suspaceflight/lora-tracker/slim-board/slim-lora.png

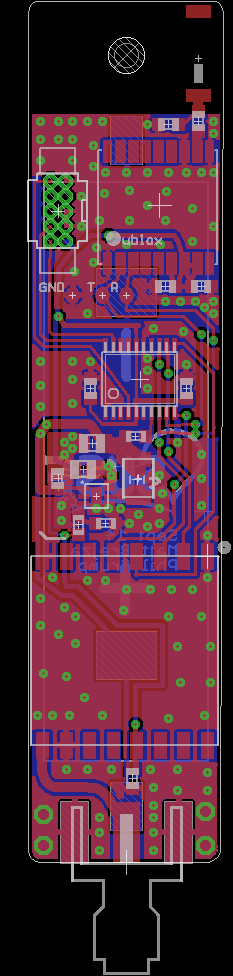
slim-board/slim-lora.png
