suspaceflight/lora-tracker/basestation-board/switchcap.SLDPRT

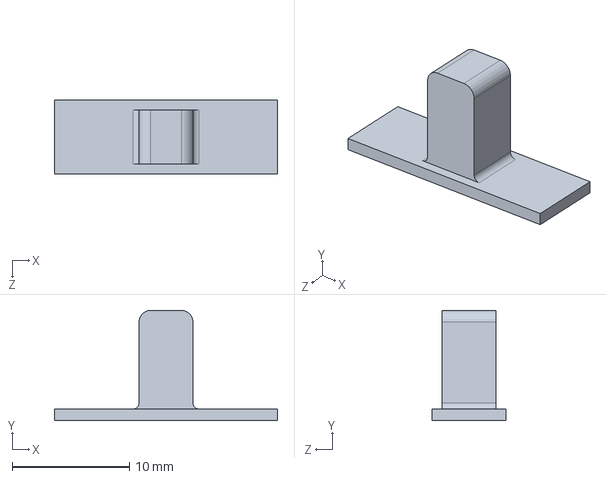
[picture p2: CAD file, 2015-01-24]
basestation-board/switchcap.SLDPRT
19.0 x 9.40 x 6.30 mm
