suspaceflight/lora-tracker/basestation-board/basestation.brd

## EAGLE design basestation-board/basestation.brd (2014-10-27)

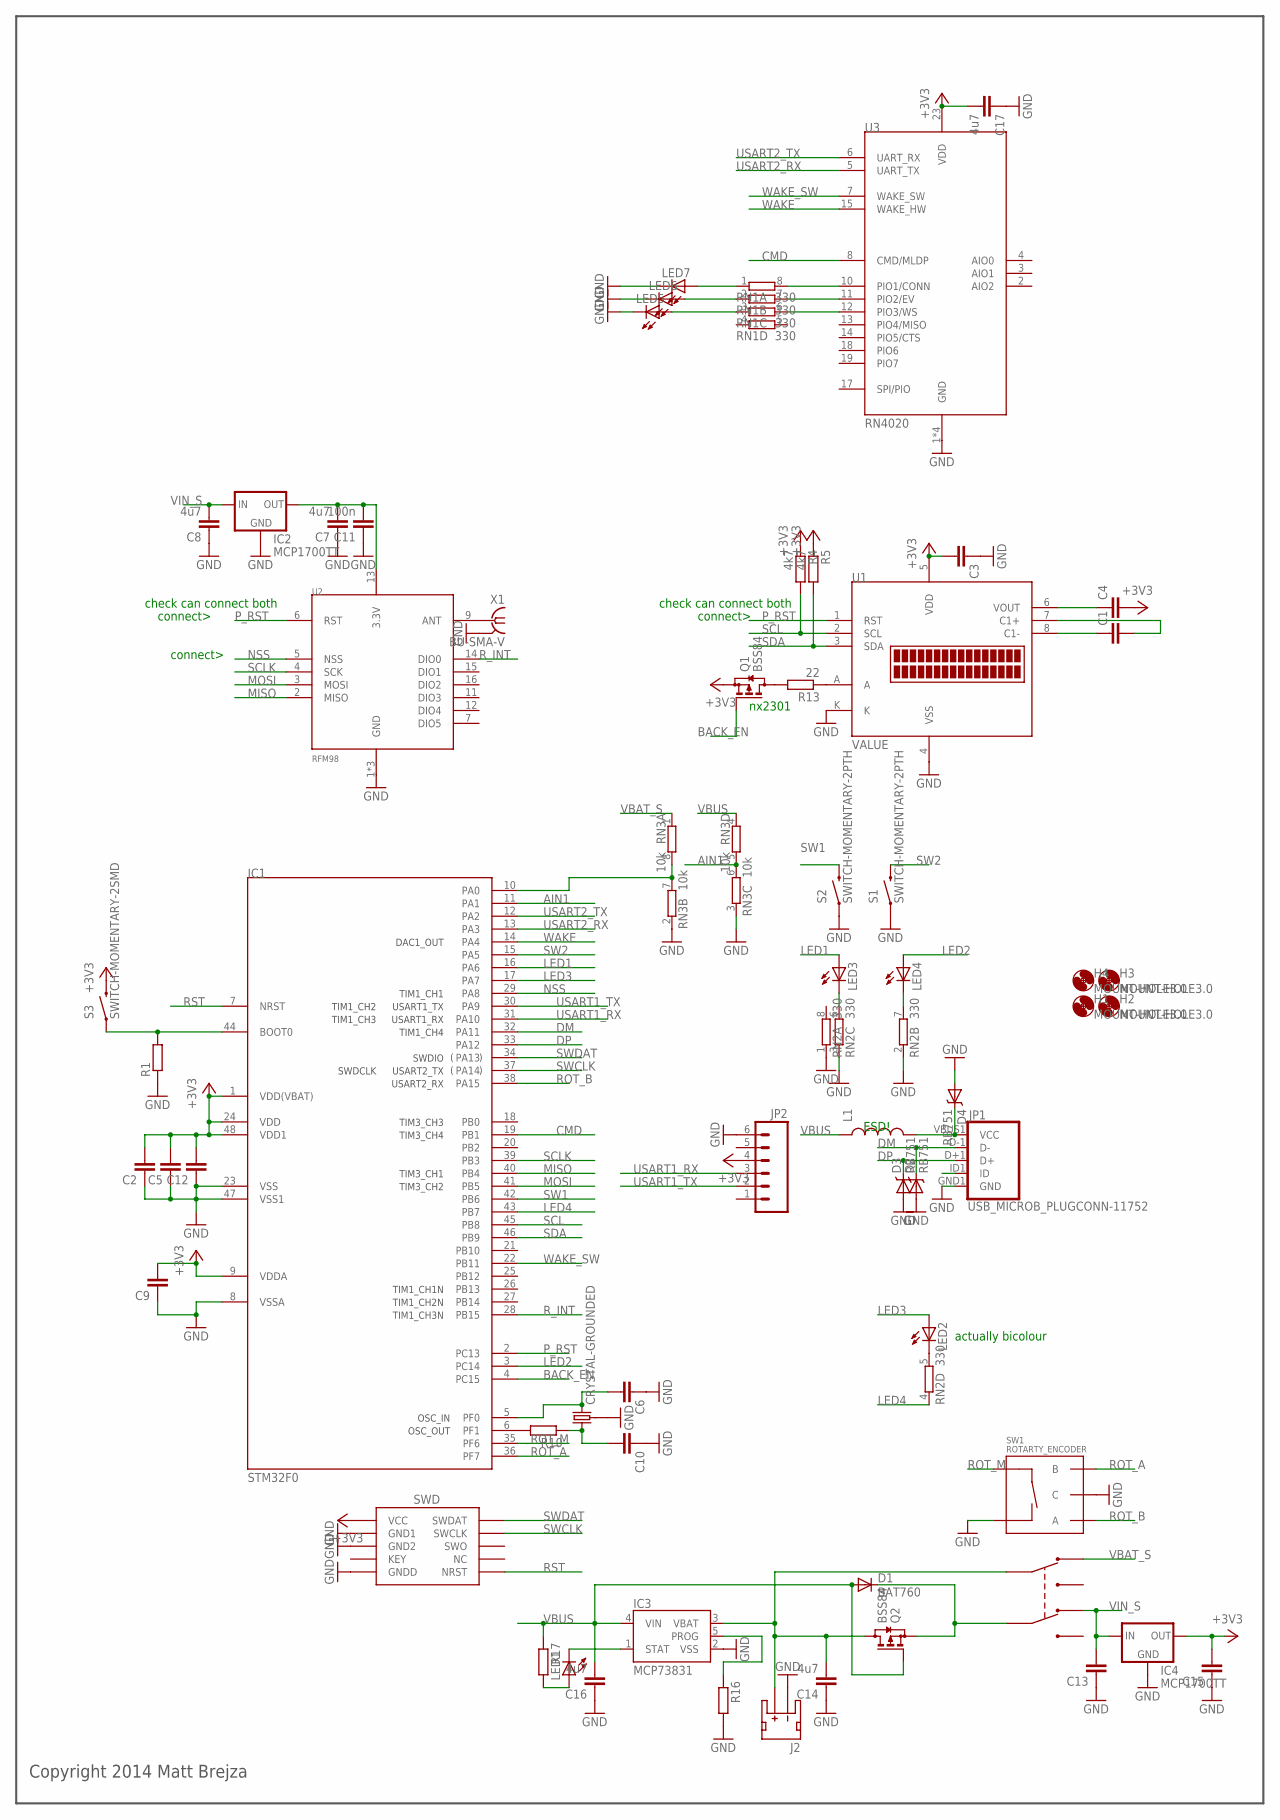
[picture p3: schematic basestation.sch]

Parts:
C1, C2, C3, C4, C5, C6, C9, C10, C12, C13, C15: C-EUC0603; C0603
C7, C8, C14, C16, C17: 4u7; C0603
C11: 100n; C0603
D1: BAT760; SOD323-R
D2, D3, D4: RB751; SOD-523
H1, H2, H3, H4: MOUNT-HOLE3.0; 3,0
IC1: STM32F0; TQFP48
IC2, IC4: MCP1700TT; SOT23
IC3: MCP73831; SOT23-5
J1: SWD_SHROUD_SMD; SWD_SMD_SHROUD
J2: JST_2MM_MALE; JST-2-SMD
JP1: USB_MICROB_PLUGCONN-11752; USB-B-MICRO-SMD_V03
JP2: M06SMD; 1X06-SMD
L1: INDUCTOR0603; 0603
LED1, LED5, LED6, LED7: LEDCHIP-LED0805; CHIP-LED0805
LED2: LED5MM
LED3, LED4: LED3MM
Q1, Q2: BSS84; SOT23
R1, R10, R16, R17: R-EU_R0603; R0603
R4, R5: 4k7; R0603
R13: 22; R0603
RN1, RN2: 330; EXB38V
RN3: 10k; EXB38V
S1, S2: SWITCH-MOMENTARY-2PTH; TACTILE-PTH
S3: SWITCH-MOMENTARY-2SMD; TACTILE_SWITCH_SMD
SW1: ROTARTY_ENCODER; ROTARY_ENC_PLAIN
U1: NHD-C0216CIZ-FSW
U2: RFM98; RFM97
U3: RN4020
U$1: DPDTSLIDE
X1: BU-SMA-V
X2: CRYSTAL-GROUNDED; CRYSTAL-SMD-5X3

Connections:
3.3V: C7.2, C11.2, IC2.2 (OUT), U2.13 (3.3V)
+3V3: C2.2, C3.2, C4.2, C5.2, C9.2, C12.2, C15.2, C17.2, IC1.1 (VDD(VBAT)), IC1.9 (VDDA), IC1.24 (VDD), IC1.48 (VDD1), IC4.2 (OUT), J1.1 (VCC), JP2.4, Q1.2 (S), R4.1, R5.1, S3.3 (2), U1.5 (VDD), U3.23 (VDD)
AIN1: IC1.11 (PA1), RN3.5 (2), RN3.6 (2)
BACK_EN: IC1.4 (PC15), Q1.1 (G)
CMD: IC1.19 (PB1), U3.8 (CMD/MLDP)
DM: D2.C, IC1.32 (PA11), JP1.D-1 (D-)
DP: D3.C, IC1.33 (PA12), JP1.D+1 (D+)
GND: C2.1, C3.1, C5.1, C6.1, C7.1, C8.1, C9.1, C10.1, C11.1, C12.1, C13.1, C14.1, C15.1, C16.1, C17.1, D2.A, D3.A, D4.A, IC1.8 (VSSA), IC1.23 (VSS), IC1.47 (VSS1), IC2.1 (GND), IC3.2 (VSS), IC4.1 (GND), J1.3 (GND1), J1.5 (GND2), J1.9 (GNDD), J2.1 (-), JP1.GND1 (GND), JP2.6, LED5.C, LED6.C, LED7.C, R1.1, R16.2, RN2.1, RN2.2 (1), RN2.3 (1), RN3.2 (1), RN3.3 (1), S1.1, S2.1, SW1.C, SW1.SW-, U1.4 (VSS), U1.K, U2.1 (GND), U2.8 (GND), U2.10 (GND), U3.1 (GND), U3.9 (GND), U3.16 (GND), U3.24 (GND), X1.2, X1.3 (2), X1.4 (2), X1.5 (2), X2.2 (3), X2.4 (3)
LED1: IC1.16 (PA6), LED3.A
LED2: IC1.3 (PC14), LED4.A
LED3: IC1.17 (PA7), LED2.A
LED4: IC1.43 (PB7), RN2.4 (1)
MISO: IC1.40 (PB4), U2.2 (MISO)
MOSI: IC1.41 (PB5), U2.3 (MOSI)
unnamed: U2.9 (ANT), X1.1
unnamed: D1.C, Q2.2 (S), U$1.2X (COM1)
unnamed: Q1.3 (D), R13.2
unnamed: IC1.44 (BOOT0), R1.2, S3.1
unnamed: RN1.8 (2), U3.10 (PIO1/CONN)
unnamed: LED3.K (C), RN2.6 (2)
unnamed: IC3.5 (PROG), R16.1
unnamed: C1.1, U1.8 (C1-)
unnamed: C1.2, U1.7 (C1+)
unnamed: LED4.K (C), RN2.7 (2)
unnamed: LED2.K (C), RN2.5 (2)
unnamed: C4.1, U1.6 (VOUT)
unnamed: RN1.7 (2), U3.11 (PIO2/EV)
unnamed: RN1.6 (2), U3.12 (PIO3/WS)
unnamed: LED7.A, RN1.1
unnamed: LED6.A, RN1.2 (1)
unnamed: LED5.A, RN1.3 (1)
unnamed: R13.1, U1.A
unnamed: IC1.10 (PA0), RN3.7 (2), RN3.8 (2)
unnamed: IC3.1 (STAT), LED1.C
unnamed: IC1.6 (PF1), R10.2
unnamed: C6.2, IC1.5 (PF0), X2.1 (2)
unnamed: C10.2, R10.1, X2.3 (1)
unnamed: C14.2, IC3.3 (VBAT), J2.2 (+), Q2.3 (D), U$1.1X (COM0)
unnamed: LED1.A, R17.2
unnamed: D4.C, JP1.VBUS1 (VCC), L1.2
NSS: IC1.29 (PA8), U2.5 (NSS)
P_RST: IC1.2 (PC13), U1.1 (RST), U2.6 (RST)
ROT_A: IC1.36 (PF7), SW1.B
ROT_B: IC1.38 (PA15), SW1.A
ROT_M: IC1.35 (PF6), SW1.SW+
RST: IC1.7 (NRST), J1.10 (NRST)
R_INT: IC1.28 (PB15), U2.14 (DIO0)
SCL: IC1.45 (PB8), R4.2, U1.2 (SCL)
SCLK: IC1.39 (PB3), U2.4 (SCK)
SDA: IC1.46 (PB9), R5.2, U1.3 (SDA)
SW1: IC1.42 (PB6), S2.3 (2)
SW2: IC1.15 (PA5), S1.3 (2)
SWCLK: IC1.37 (PA14), J1.4 (SWCLK)
SWDAT: IC1.34 (PA13), J1.2 (SWDAT)
USART1_RX: IC1.31 (PA10), JP2.3
USART1_TX: IC1.30 (PA9), JP2.2
USART2_RX: IC1.13 (PA3), U3.5 (UART_TX)
USART2_TX: IC1.12 (PA2), U3.6 (UART_RX)
VBAT_S: RN3.1, U$1.1A (NC0)
VBUS: C16.2, D1.A, IC3.4 (VIN), L1.1, Q2.1 (G), R17.1, RN3.4 (1)
VIN_S: C8.2, C13.2, IC2.3 (IN), IC4.3 (IN), U$1.2A (NC1)
WAKE: IC1.14 (PA4), U3.15 (WAKE_HW)
WAKE_SW: IC1.22 (PB11), U3.7 (WAKE_SW)

Notes on the sheet:
actually bicolour
connect>
nx2301
ESD!
check can connect both
Copyright 2014 Matt Brejza

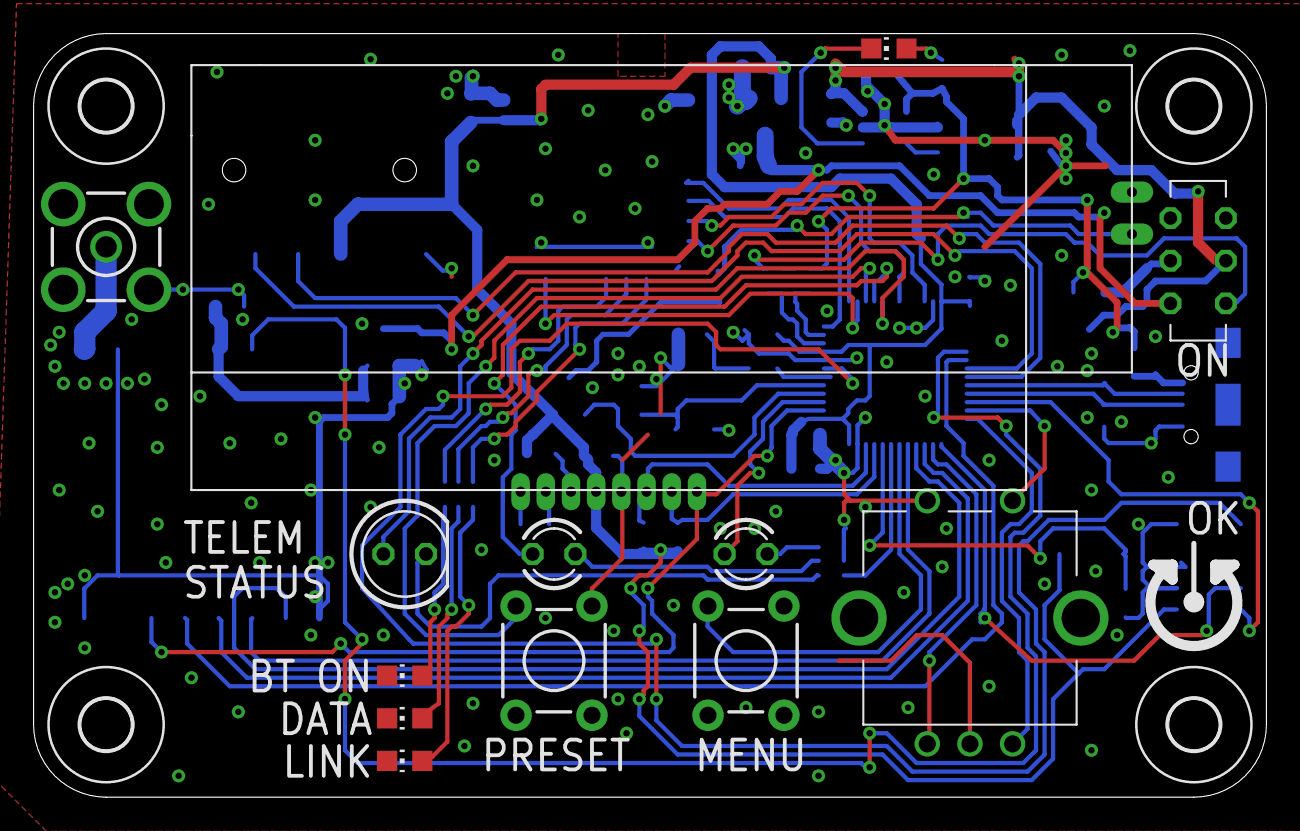
[picture p4: board basestation.brd from above]

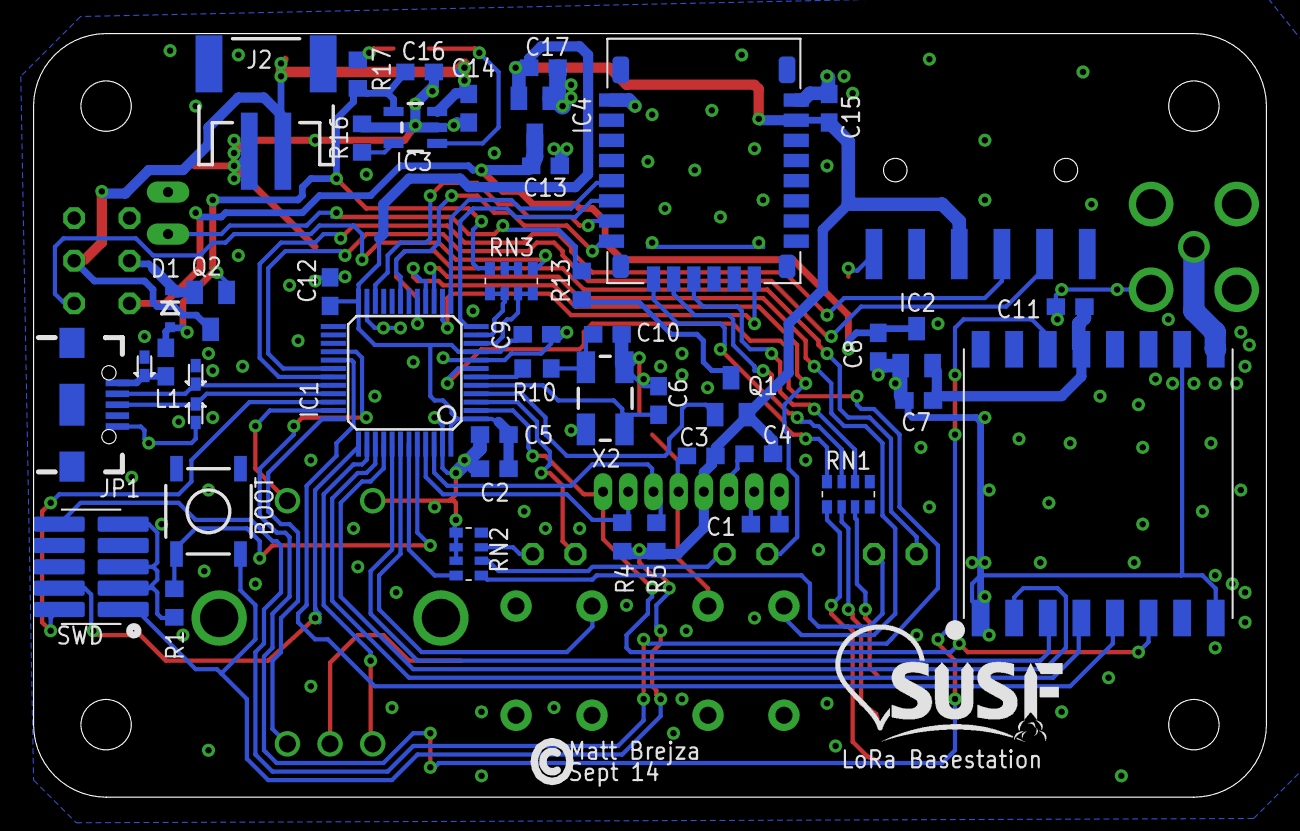
[picture p5: board basestation.brd from below]

Board: 2 copper layers, 73.4 x 45.5 mm, 64 parts (47 on the bottom side), 63 nets.

Other parts of the board:
U$2: SUSF-XSM
