suspaceflight/lora-tracker/th-lora/th-lora.brd

## EAGLE design th-lora/th-lora.brd (2014-10-27)

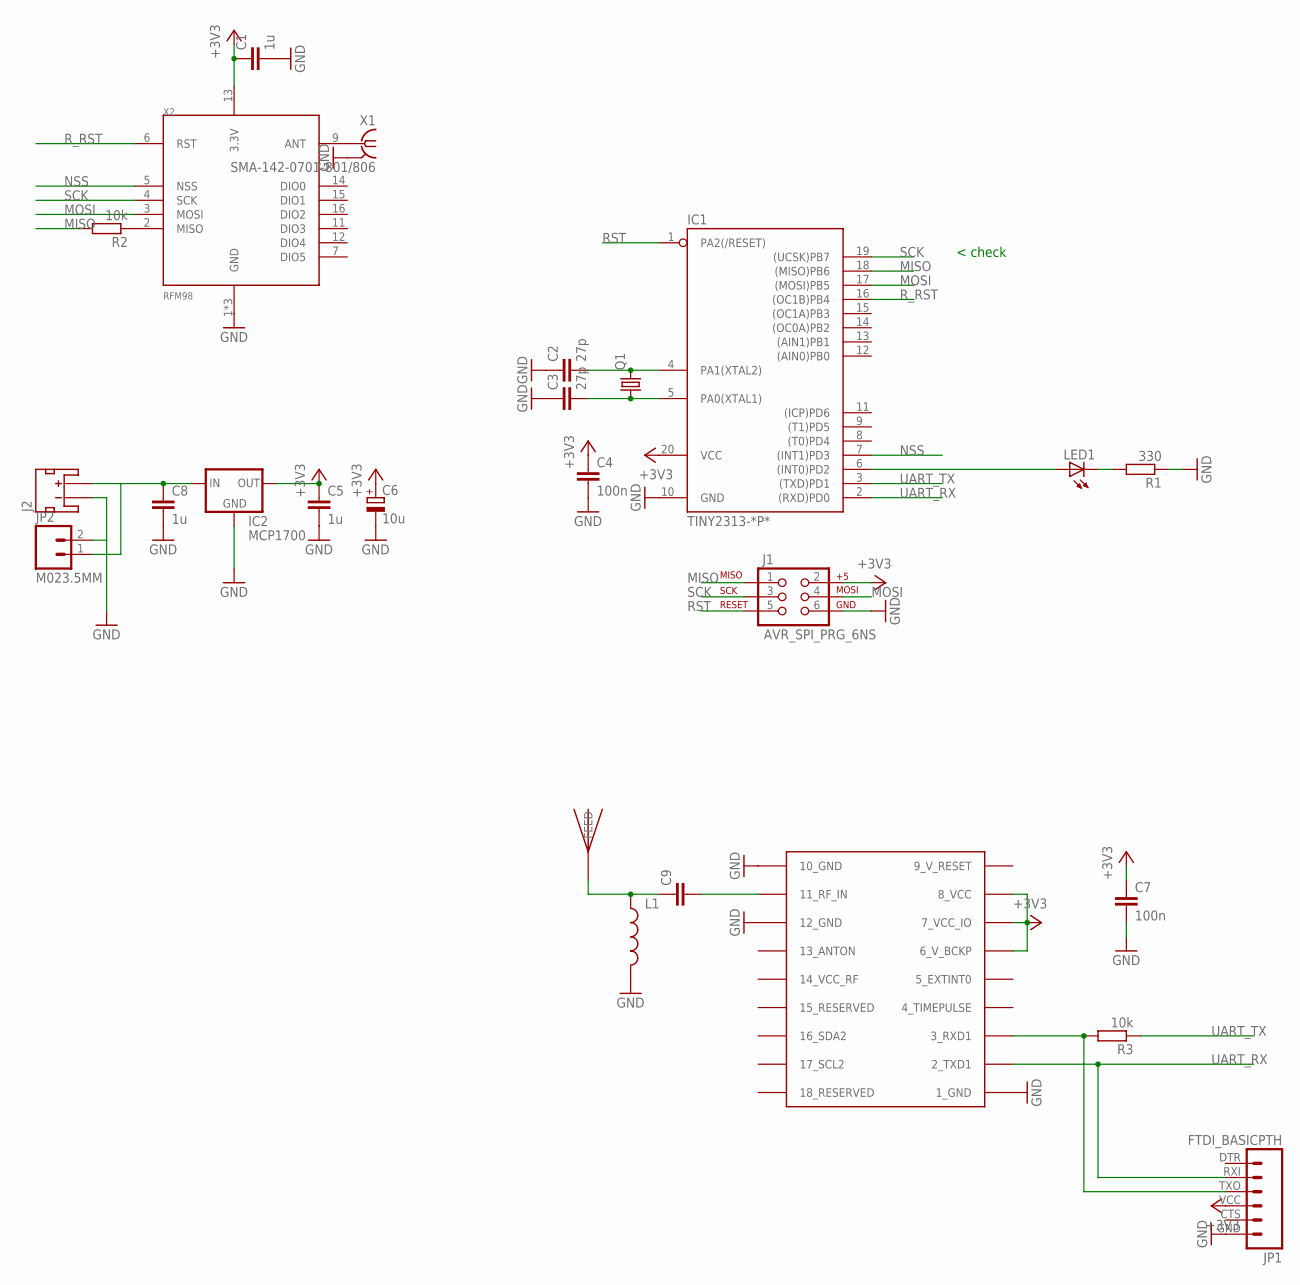
[picture p6: schematic th-lora.sch]

Parts:
C1, C5, C8: 1u; C050-025X075
C2, C3: 27p; C050-025X075
C4, C7: 100n; C050-025X075
C6: 10u; E2,5-5
C9: C-EUC0603; C0603
IC1: TINY2313-*P*; DIL20
IC2: MCP1700; TO92-INLINE
J1: AVR_SPI_PRG_6NS; 2X3-NS
J2: JST_2MM_MALE; JST-2-SMD
JP1: FTDI_BASICPTH; FTDI_BASIC
JP2: M023.5MM; SCREWTERMINAL-3.5MM-2
L1: INDUCTOR0603; 0603
LED1: LED3MM
Q1: CRYSTALHC49S; HC49/S
R1: 330; 0204/7
R2, R3: 10k; 0204/7
U$3: JTI_ANTENNA-1575AT43A40
X1: SMA-142-0701-801/806; J502-ND-142-0701-801/806
X2: RFM98; RFM97
X3: UBLOX_MAX

Connections:
9_V_RESET: X3.9_V_RESET
+3V3: C1.1, C4.1, C5.1, C6.+, C7.1, IC1.20 (VCC), IC2.VOUT (OUT), J1.2, JP1.VCC (4), X2.13 (3.3V), X3.6_V_BCKP, X3.7_VCC_IO, X3.8_VCC
GND: C1.2, C2.1, C3.1, C4.2, C5.2, C6.-, C7.2, C8.2, IC1.10 (GND), IC2.GND, J1.6, J2.1 (-), JP1.GND (6), JP2.2, L1.2, R1.1, X1.G@1 (2), X1.G@2 (2), X1.G@3 (2), X1.G@4 (2), X2.1 (GND), X2.8 (GND), X2.10 (GND), X3.1_GND, X3.10_GND, X3.12_GND
MISO: IC1.18 ((MISO)PB6), J1.1, R2.2
MOSI: IC1.17 ((MOSI)PB5), J1.4, X2.3 (MOSI)
unnamed: C9.2, X3.11_RF_IN
unnamed: X1.1, X2.9 (ANT)
unnamed: LED1.K (C), R1.2
unnamed: C9.1, L1.1, U$3.FEED
unnamed: C2.2, IC1.4 (PA1(XTAL2)), Q1.2
unnamed: C3.2, IC1.5 (PA0(XTAL1)), Q1.1
unnamed: C8.1, IC2.VIN (IN), J2.2 (+), JP2.1
unnamed: IC1.6 ((INT0)PD2), LED1.A
unnamed: JP1.TXO (3), R3.2, X3.3_RXD1
unnamed: R2.1, X2.2 (MISO)
NSS: IC1.7 ((INT1)PD3), X2.5 (NSS)
RST: IC1.1 (PA2(/RESET)), J1.5
R_RST: IC1.16 ((OC1B)PB4), X2.6 (RST)
SCK: IC1.19 ((UCSK)PB7), J1.3, X2.4 (SCK)
UART_RX: IC1.2 ((RXD)PD0), JP1.RXI (2), X3.2_TXD1
UART_TX: IC1.3 ((TXD)PD1), R3.1

Notes on the sheet:
< check

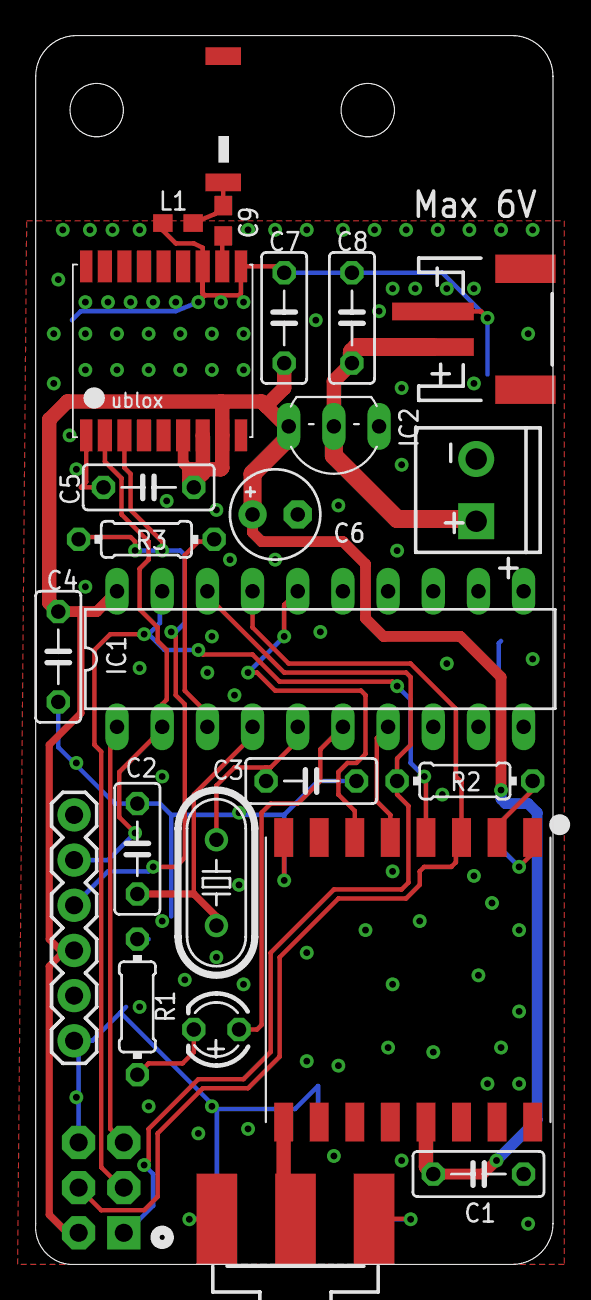
[picture p7: board th-lora.brd from above]

Board: 2 copper layers, 29.1 x 69.1 mm, 26 parts (1 on the bottom side), 20 nets.

Other parts of the board:
U$4: SUSF-XSM
