suspaceflight/lora-tracker/slim-board/lora-slim.brd

## EAGLE design slim-board/lora-slim.brd (2014-10-27)

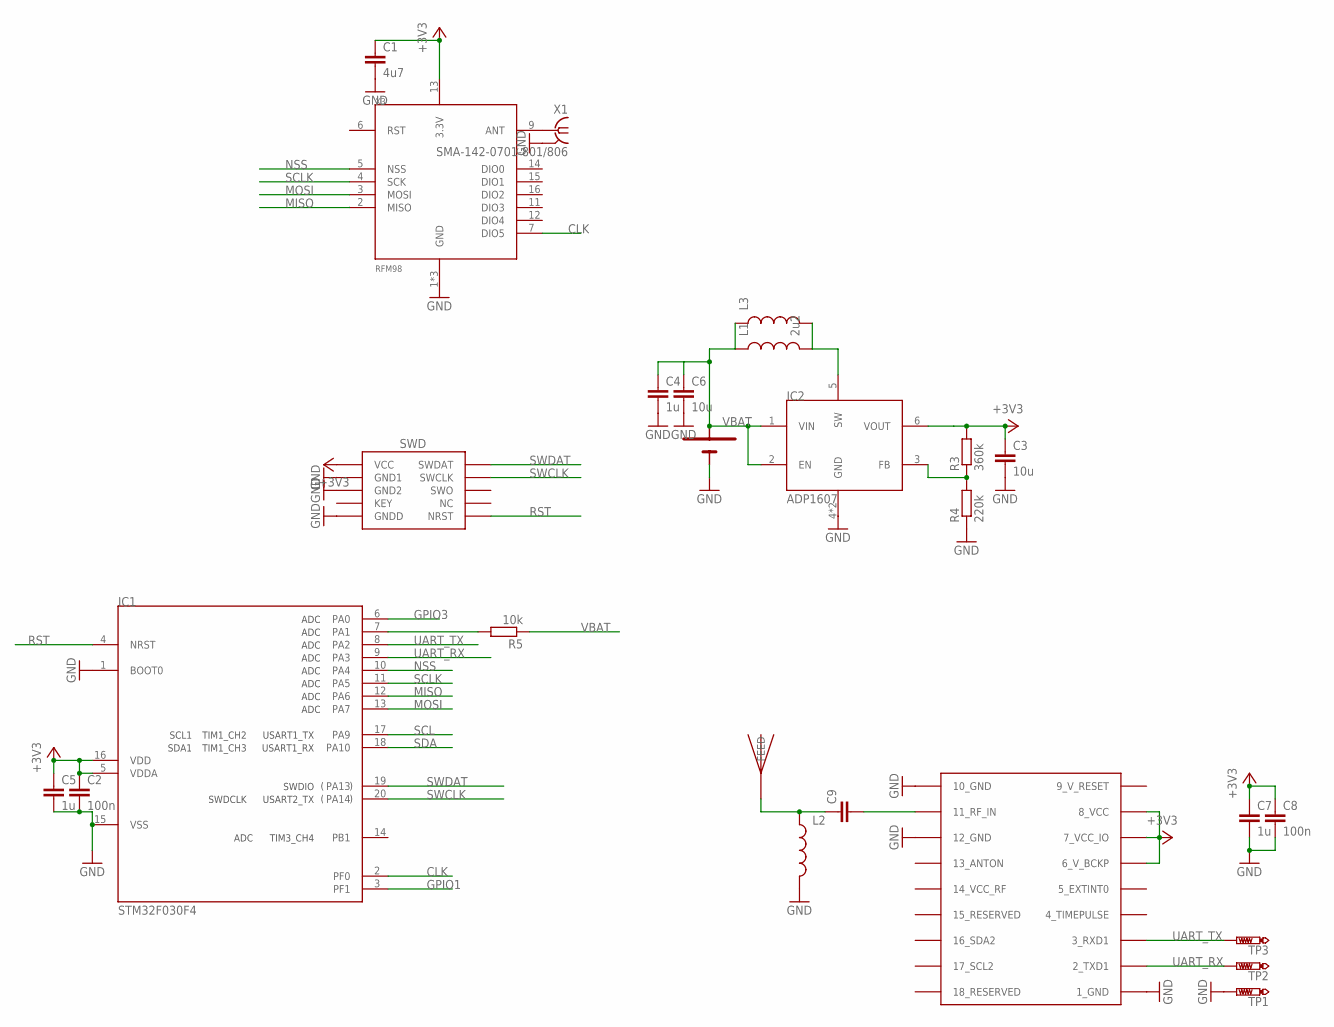
[picture p8: schematic lora-slim.sch]

Parts:
C1: 4u7; C0603
C2, C8: 100n; C0603
C3, C6: 10u; C0805
C4, C5, C7: 1u; C0603
C9: C-EUC0603; C0603
IC1: STM32F030F4; TSSOP20
IC2: ADP1607; LFCSP6
J1: SWD_PTH_SHROUD
L1: 2u2; 0805
L2: INDUCTOR0603; 0603
L3: INDUCTOR1210; 1210
R3: 360k; R0603
R4: 220k; R0603
R5: 10k; R0603
TP1, TP2, TP3: PTR1B1,27; B1,27
U$5: JTI_ANTENNA-1575AT43A40
U$6: KEYSTONE-53; KEYSTONE53
X1: SMA-142-0701-801/806; J502-ND-142-0701-801/806
X2: UBLOX_MAX
X3: RFM98; RFM97

Connections:
9_V_RESET: X2.9_V_RESET
+3V3: C1.1, C2.1, C3.1, C5.1, C7.1, C8.1, IC1.5 (VDDA), IC1.16 (VDD), IC2.6 (VOUT), J1.1 (VCC), R3.2, X2.6_V_BCKP, X2.7_VCC_IO, X2.8_VCC, X3.13 (3.3V)
CLK: IC1.2 (PF0), X3.7 (DIO5)
GND: C1.2, C2.2, C3.2, C4.2, C5.2, C6.2, C7.2, C8.2, IC1.1 (BOOT0), IC1.15 (VSS), IC2.4 (GND), IC2.EP (GND), J1.3 (GND1), J1.5 (GND2), J1.9 (GNDD), L2.2, R4.1, TP1.TP, U$6.N1 (-), U$6.N2 (-), X1.G@1 (2), X1.G@2 (2), X1.G@3 (2), X1.G@4 (2), X2.1_GND, X2.10_GND, X2.12_GND, X3.1 (GND), X3.8 (GND), X3.10 (GND)
GPIO1: IC1.3 (PF1)
GPIO3: IC1.6 (PA0)
MISO: IC1.12 (PA6), X3.2 (MISO)
MOSI: IC1.13 (PA7), X3.3 (MOSI)
unnamed: C9.2, X2.11_RF_IN
unnamed: X1.1, X3.9 (ANT)
unnamed: IC2.5 (SW), L1.2, L3.2
unnamed: C9.1, L2.1, U$5.FEED
unnamed: IC2.3 (FB), R3.1, R4.2
unnamed: IC1.7 (PA1), R5.2
NSS: IC1.10 (PA4), X3.5 (NSS)
RST: IC1.4 (NRST), J1.10 (NRST)
SCL: IC1.17 (PA9)
SCLK: IC1.11 (PA5), X3.4 (SCK)
SDA: IC1.18 (PA10)
SWCLK: IC1.20 (PA14), J1.4 (SWCLK)
SWDAT: IC1.19 (PA13), J1.2 (SWDAT)
UART_RX: IC1.9 (PA3), TP2.TP, X2.2_TXD1
UART_TX: IC1.8 (PA2), TP3.TP, X2.3_RXD1
VBAT: C4.1, C6.1, IC2.1 (VIN), IC2.2 (EN), L1.1, L3.1, R5.1, U$6.P1 (+), U$6.P2 (+)

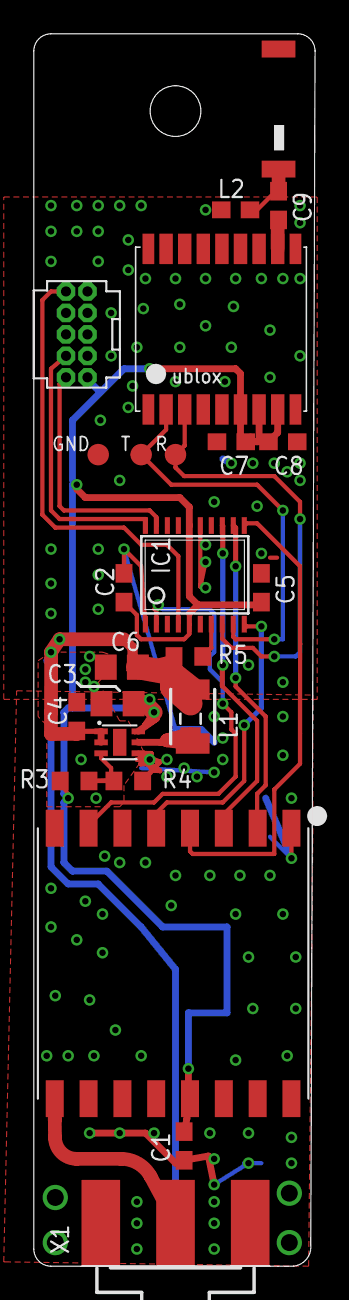
[picture p9: board lora-slim.brd from above]

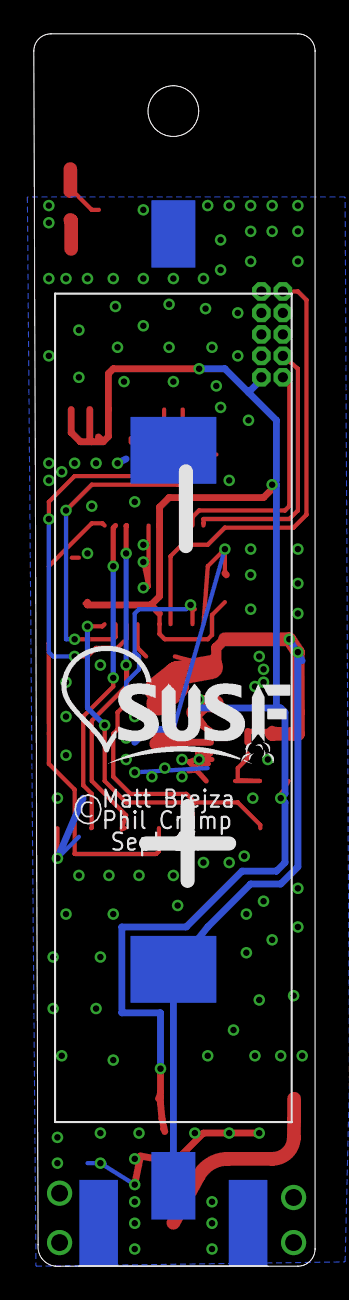
[picture p10: board lora-slim.brd from below]

Board: 2 copper layers, 16.6 x 72.9 mm, 27 parts (2 on the bottom side), 19 nets.

Other parts of the board:
U$1: SUSF-XSM
