suspaceflight/lora-tracker/gerbers/v1/combined.brd

## EAGLE design gerbers/v1/combined.brd (2014-10-04)

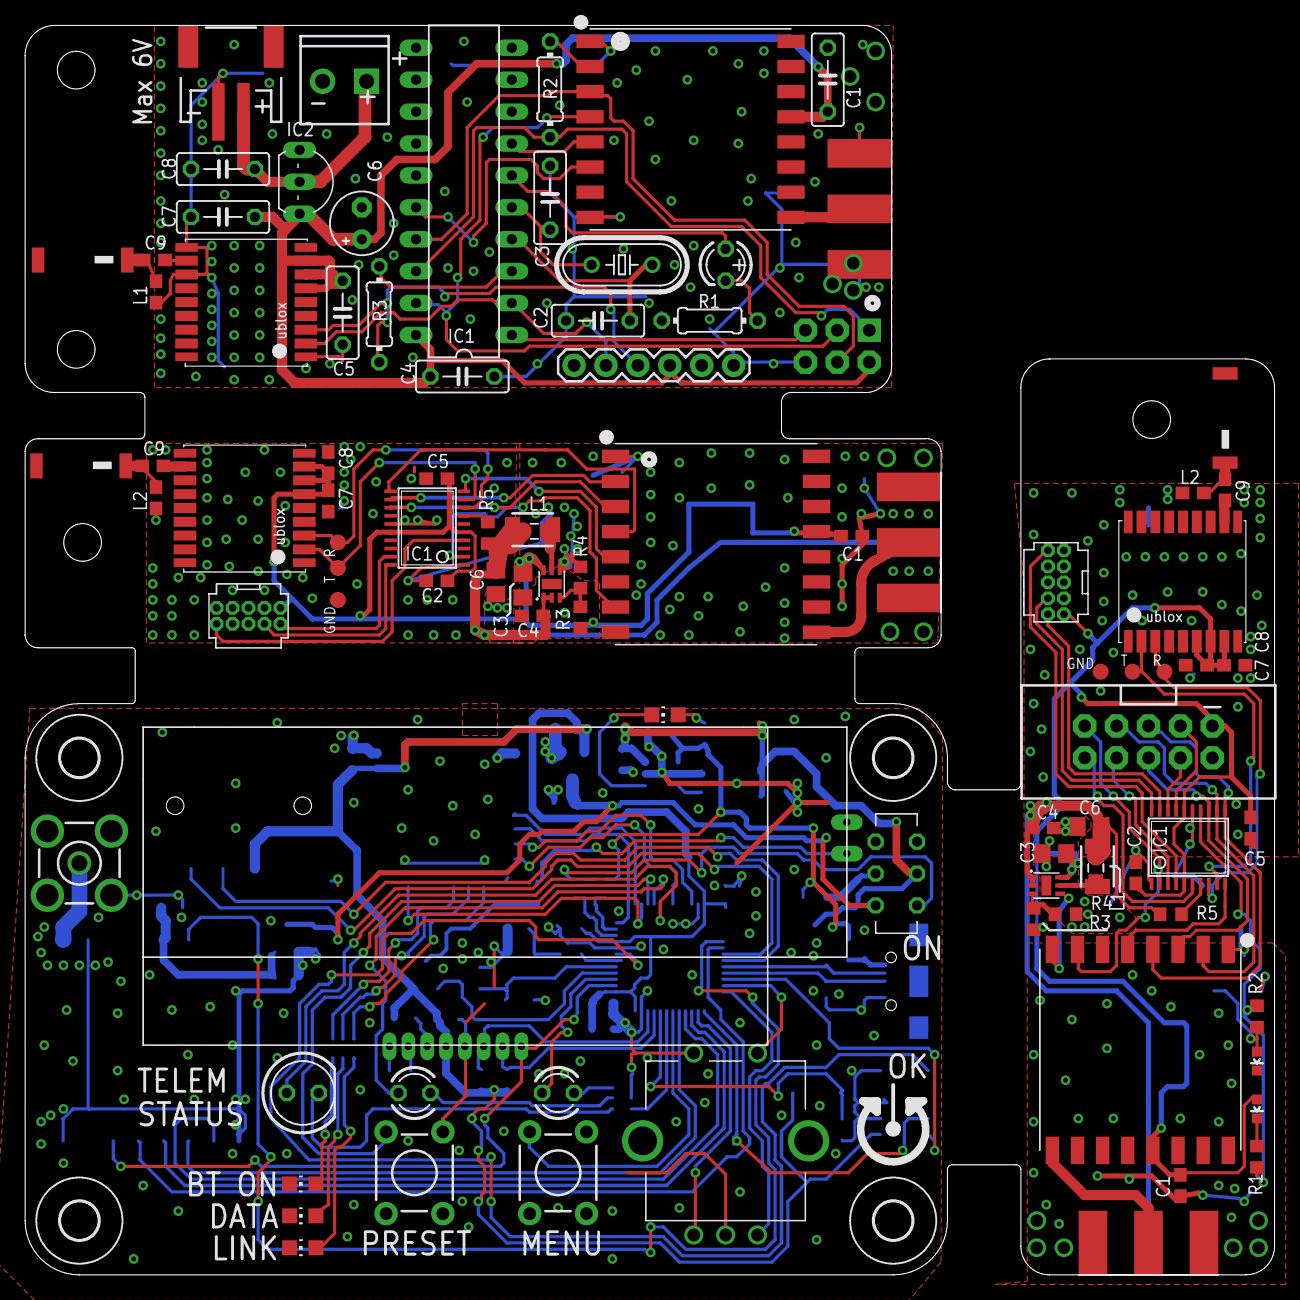
[picture p11: board combined.brd from above]

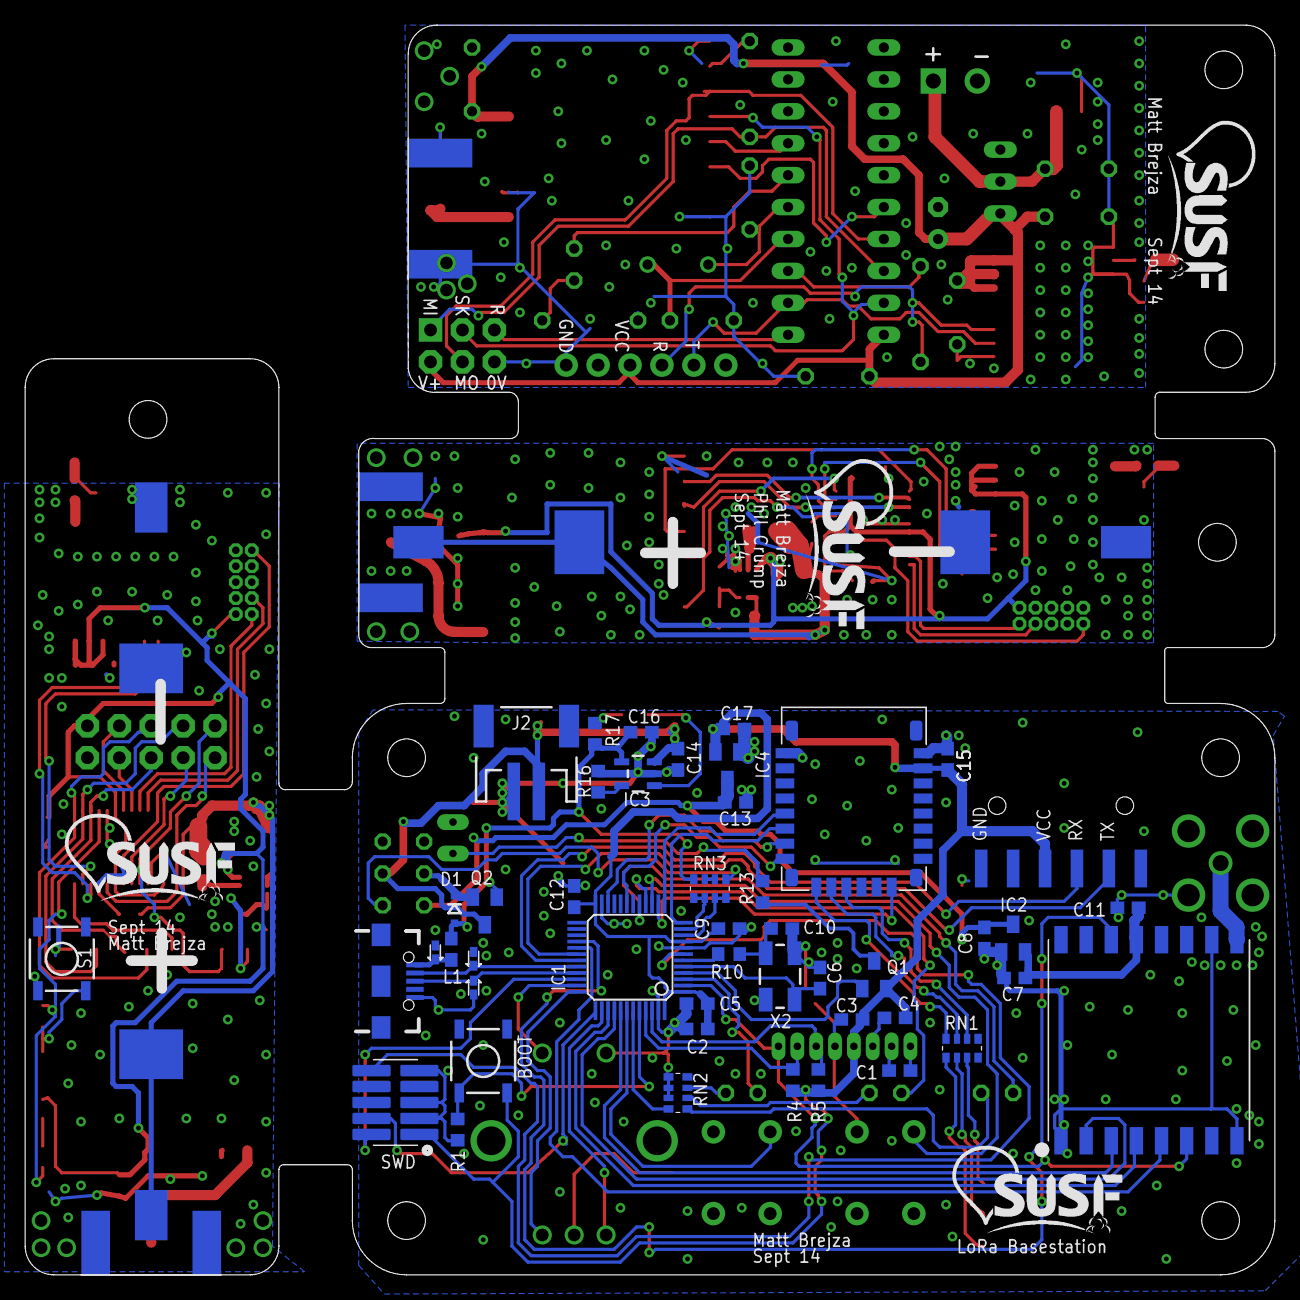
[picture p12: board combined.brd from below]

Board: 2 copper layers, 99.4 x 99.4 mm, 150 parts (53 on the bottom side), 127 nets.

Parts:
C1, C2, C3, C4, C5, C6, C9, C10, C12, C13, C15, C25, C34, C36: C0603
C7, C8, C14, C16, C17, C22, C31: 4u7; C0603
C11, C20, C24, C29, C33: 100n; C0603
C18, C19, C27, C28: 10u; C0805
C21, C23, C26, C30, C32, C35: 1u; C0603
C37, C42: 100n; C050-025X075
C38, C39, C43: 1u; C050-025X075
C40, C41: 27p; C050-025X075
C44: 10u; E2,5-5
D1: BAT760; SOD323-R
D2, D3, D4: RB751; SOD-523
H1, H2, H3, H4: MOUNT-HOLE3.0; 3,0
IC1: STM32F0; TQFP48
IC2, IC4: MCP1700TT; SOT23
IC3: MCP73831; SOT23-5
IC5, IC7: STM32F030F4; TSSOP20
IC6, IC8: ADP1607; LFCSP6
IC9: TINY2313-*P*; DIL20
IC10: MCP1700; TO92-INLINE
J1: SWD_SHROUD_SMD; SWD_SMD_SHROUD
J2, J6: JST-2-SMD
J3, J4: SWD_PTH_SHROUD
J5: AVR_SPI_PRG_6NS; 2X3-NS
JP1: USB_MICROB_PLUGCONN-11752; USB-B-MICRO-SMD_V03
JP2: 1X06-SMD
JP3: M05X2SHD; 2X5-SHROUDED
JP4: M023.5MM; SCREWTERMINAL-3.5MM-2
JP5: FTDI_BASICPTH; FTDI_BASIC
L1, L3, L6, L8: 0603
L2, L5: 2u2; 0805
L4, L7: 1210
LED1, LED5, LED6, LED7: CHIP-LED0805
LED2: LED5MM
LED3, LED4, LED10: LED3MM
LED8, LED9: LED-0603
Q1, Q2: BSS84; SOT23
Q3: HC49/S
R1, R10, R16, R17: R0603
R2, R11: 220k; R0603
R3, R9: 360k; R0603
R4, R5: 4k7; R0603
R6, R7: 330; R0603
R8, R12: 10k; R0603
R13: 22; R0603
R14: 330; 0204/7
R15, R18: 10k; 0204/7
RN1, RN2: 330; EXB38V
RN3: 10k; EXB38V
S1, S2: SWITCH-MOMENTARY-2PTH; TACTILE-PTH
S3, S4: SWITCH-MOMENTARY-2SMD; TACTILE_SWITCH_SMD
SW1: ROTARTY_ENCODER; ROTARY_ENC_PLAIN
TP1, TP2, TP3, TP4, TP5, TP6: PTR1B1,27; B1,27
U1: NHD-C0216CIZ-FSW
U2: RFM98; RFM97
U3: RN4020
U$1: DPDTSLIDE
U$2, U$3, U$8, U$10: SUSF-XSM
U$4, U$5, U$9: JTI_ANTENNA-1575AT43A40
U$6, U$7: KEYSTONE-53; KEYSTONE53
X1: BU-SMA-V
X2: CRYSTAL-GROUNDED; CRYSTAL-SMD-5X3
X3, X6, X9: UBLOX_MAX
X4, X7, X10: SMA-142-0701-801/806; J502-ND-142-0701-801/806
X5, X8, X11: RFM98; RFM97

Connections:
3.3V: C7.2, C11.2, IC2.2, U2.13
+3V1: C18.1, C20.1, C21.1, C22.1, C23.1, C24.1, IC5.5, IC5.16, IC6.6, J3.1, JP3.1, LED9.A, R3.2, X3.6_V_BCKP, X3.7_VCC_IO, X3.8_VCC, X5.13
+3V2: C27.1, C29.1, C30.1, C31.1, C32.1, C33.1, IC7.5, IC7.16, IC8.6, J4.1, R9.2, X6.6_V_BCKP, X6.7_VCC_IO, X6.8_VCC, X8.13
+3V3: C2.2, C3.2, C4.2, C5.2, C9.2, C12.2, C15.2, C17.2, IC1.1, IC1.9, IC1.24, IC1.48, IC4.2, J1.1, JP2.4, Q1.2, R4.1, R5.1, S3.3, U1.5, U3.23
+3V4: C37.1, C38.1, C42.1, C43.1, C44.+, IC9.20, IC10.VOUT, J5.2, JP5.VCC, X9.6_V_BCKP, X9.7_VCC_IO, X9.8_VCC, X11.13
AIN1: IC1.11, RN3.5, RN3.6
BACK_EN: IC1.4, Q1.1
CLK: IC7.2, X8.7
CMD: IC1.19, U3.8
DM: D2.C, IC1.32, JP1.D-1
DP: D3.C, IC1.33, JP1.D+1
GND: C2.1, C3.1, C5.1, C6.1, C7.1, C8.1, C9.1, C10.1, C11.1, C12.1, C13.1, C14.1, C15.1, C16.1, C17.1, D2.A, D3.A, D4.A, IC1.8, IC1.23, IC1.47, IC2.1, IC3.2, IC4.1, J1.3, J1.5, J1.9, J2.1, JP1.GND1, JP2.6, LED5.C, LED6.C, LED7.C, R1.1, R16.2, RN2.1, RN2.2, RN2.3, RN3.2, RN3.3, S1.1, S2.1, SW1.C, SW1.SW-, U1.4, U1.K, U2.1, U2.8, U2.10, U3.1, U3.9, U3.16, U3.24, X1.2, X1.3, X1.4, X1.5, X2.2, X2.4
GND2: C27.2, C28.2, C29.2, C30.2, C31.2, C32.2, C33.2, C35.2, IC7.1, IC7.15, IC8.4, IC8.EP, J4.3, J4.5, J4.9, L6.2, R11.1, TP6.TP, U$7.N1, U$7.N2, X6.1_GND, X6.10_GND, X6.12_GND, X7.G@1, X7.G@2, X7.G@3, X7.G@4, X8.1, X8.8, X8.10
GND3: C18.2, C19.2, C20.2, C21.2, C22.2, C23.2, C24.2, C26.2, C37.2, C38.2, C39.2, C40.1, C41.1, C42.2, C43.2, C44.-, IC5.1, IC5.15, IC6.4, IC6.EP, IC9.10, IC10.GND, J3.3, J3.5, J3.9, J5.6, J6.1, JP3.2, JP4.2, JP5.GND, L3.2, L8.2, LED8.C, R2.1, R14.1, S4.1, TP1.TP, U$6.N1, U$6.N2, X3.1_GND, X3.10_GND, X3.12_GND, X4.G@1, X4.G@2, X4.G@3, X4.G@4, X5.1, X5.8, X5.10, X9.1_GND, X9.10_GND, X9.12_GND, X10.G@1, X10.G@2, X10.G@3, X10.G@4, X11.1, X11.8, X11.10
GPIO1: IC5.3, JP3.8
GPIO2: IC5.2, JP3.9, X5.7
GPIO3: IC5.6, JP3.10
LED1: IC1.16, LED3.A
LED2: IC1.3, LED4.A
LED3: IC1.17, LED2.A
LED4: IC1.43, RN2.4
MISO: IC1.40, U2.2
MISO1: IC5.12, JP3.7, X5.2
MISO2: IC7.12, X8.2
MISO3: IC9.18, J5.1, R18.2
MOSI: IC1.41, U2.3
MOSI1: IC5.13, JP3.6, X5.3
MOSI2: IC7.13, X8.3
MOSI3: IC9.17, J5.4, X11.3
unnamed: U2.9, X1.1
unnamed: D1.C, Q2.2, U$1.2X
unnamed: Q1.3, R13.2
unnamed: IC1.44, R1.2, S3.1
unnamed: RN1.8, U3.10
unnamed: LED3.K, RN2.6
unnamed: IC3.5, R16.1
unnamed: C1.1, U1.8
unnamed: C1.2, U1.7
unnamed: LED4.K, RN2.7
unnamed: LED2.K, RN2.5
unnamed: C4.1, U1.6
unnamed: RN1.7, U3.11
unnamed: RN1.6, U3.12
unnamed: LED7.A, RN1.1
unnamed: LED6.A, RN1.2
unnamed: LED5.A, RN1.3
unnamed: X4.1, X5.9
unnamed: IC6.5, L2.2, L4.2
unnamed: IC6.3, R2.2, R3.1
unnamed: LED9.C, R7.2
unnamed: R13.1, U1.A
unnamed: IC5.7, R8.2
unnamed: C25.2, X3.11_RF_IN
unnamed: C25.1, L3.1, U$5.FEED
unnamed: IC1.10, RN3.7, RN3.8
unnamed: IC3.1, LED1.C
unnamed: IC1.6, R10.2
unnamed: C6.2, IC1.5, X2.1
unnamed: C10.2, R10.1, X2.3
unnamed: C14.2, IC3.3, J2.2, Q2.3, U$1.1X
unnamed: LED1.A, R17.2
unnamed: D4.C, JP1.VBUS1, L1.2
unnamed: IC5.14, R6.2, R7.1
unnamed: LED8.A, R6.1, S4.3
unnamed: X7.1, X8.9
unnamed: IC8.5, L5.2, L7.2
unnamed: IC8.3, R9.1, R11.2
unnamed: IC7.7, R12.2
unnamed: C34.2, X6.11_RF_IN
unnamed: C34.1, L6.1, U$4.FEED
unnamed: X10.1, X11.9
unnamed: C36.2, X9.11_RF_IN
unnamed: C36.1, L8.1, U$9.FEED
unnamed: C39.1, IC10.VIN, J6.2, JP4.1
unnamed: C40.2, IC9.4, Q3.2
unnamed: C41.2, IC9.5, Q3.1
unnamed: LED10.K, R14.2
unnamed: IC9.6, LED10.A
unnamed: JP5.TXO, R15.2, X9.3_RXD1
unnamed: R18.1, X11.2
NSS: IC1.29, U2.5
NSS1: IC5.10, X5.5
NSS2: IC7.10, X8.5
NSS3: IC9.7, X11.5
P_RST: IC1.2, U1.1, U2.6
ROT_A: IC1.36, SW1.B
ROT_B: IC1.38, SW1.A
ROT_M: IC1.35, SW1.SW+
RST: IC1.7, J1.10
RST1: IC5.4, J3.10
RST2: IC7.4, J4.10
RST3: IC9.1, J5.5
R_INT: IC1.28, U2.14
R_RST: IC9.16, X11.6
SCK: IC9.19, J5.3, X11.4
SCL: IC1.45, R4.2, U1.2
SCL1: IC5.17, JP3.3
SCLK: IC1.39, U2.4
SCLK1: IC5.11, JP3.5, X5.4
SCLK2: IC7.11, X8.4
SDA: IC1.46, R5.2, U1.3
SDA1: IC5.18, JP3.4
SW1: IC1.42, S2.3
SW2: IC1.15, S1.3
SWCLK: IC1.37, J1.4
SWCLK1: IC5.20, J3.4
SWCLK2: IC7.20, J4.4
SWDAT: IC1.34, J1.2
SWDAT1: IC5.19, J3.2
SWDAT2: IC7.19, J4.2
UART_RX: IC5.9, TP2.TP, X3.2_TXD1
UART_RX1: IC7.9, TP4.TP, X6.2_TXD1
UART_RX2: IC9.2, JP5.RXI, X9.2_TXD1
UART_TX: IC5.8, TP3.TP, X3.3_RXD1
UART_TX1: IC7.8, TP5.TP, X6.3_RXD1
UART_TX2: IC9.3, R15.1
USART1_RX: IC1.31, JP2.3
USART1_TX: IC1.30, JP2.2
USART2_RX: IC1.13, U3.5
USART2_TX: IC1.12, U3.6
VBAT: C19.1, C26.1, IC6.1, IC6.2, L2.1, L4.1, R8.1, U$6.P1, U$6.P2
VBAT1: C28.1, C35.1, IC8.1, IC8.2, L5.1, L7.1, R12.1, U$7.P1, U$7.P2
VBAT_S: RN3.1, U$1.1A
VBUS: C16.2, D1.A, IC3.4, L1.1, Q2.1, R17.1, RN3.4
VIN_S: C8.2, C13.2, IC2.3, IC4.3, U$1.2A
WAKE: IC1.14, U3.15
WAKE_SW: IC1.22, U3.7
