suspaceflight/lora-tracker/firmware-th/radio_config.h

#define R_CS_PORT (PORTD)
#define R_CS_PIN (1<<3)
#define DDR_R_SPI (DDRB)
#define R_SPI_OUT ((1<<7) | (1<<5))
#define DDR_R_CS (DDRD)


#define RTTY_FIFO_THRESHOLD 20

#define PORT_MOSI (PORTB)
#define INPUT_MISO (PINB)
#define PORT_CLK (PORTB)

#define PIN_MOSI (1<<5)
#define PIN_MISO (1<<6)
#define PIN_CLK (1<<7)
