suspaceflight/lora-tracker/firmware-basestation/radio_config.h

//SPI periph
#define R_SPI        SPI1
#define R_RCC_SPI    RCC_SPI1
#define R_RCC_GPIO   RCC_GPIOB
#define R_SPI_PORT   GPIOB
#define R_SPI_PINS   GPIO3 | GPIO4 | GPIO5
#define R_SPI_AFn    GPIO_AF0

#define RTTY_FIFO_THRESHOLD 20

//CS
#define R_CS_PIN     GPIO8
#define R_CS_PORT    GPIOA
