suspaceflight/lora-tracker/firmware-tracker/radio_config.h

#define R_SPI        SPI1
#define R_RCC_SPI    RCC_SPI1
#define R_RCC_GPIO   RCC_GPIOA
#define R_CS_PIN     GPIO4
#define R_CS_PORT    GPIOA
#define R_SPI_PORT   GPIOA
#define R_SPI_PINS   GPIO5 | GPIO6 | GPIO7
#define R_SPI_AFn    GPIO_AF0

#define RTTY_FIFO_THRESHOLD 20
