suspaceflight/lora-tracker/liblora/radio.c

#include <libopencm3/stm32/gpio.h>
#include <libopencm3/stm32/spi.h>
#include <libopencm3/stm32/rcc.h>
#include "radio_config.h"


#include "radio.h"

char *rtty_current_byte;
uint16_t rtty_bit_counter_mask;
uint8_t rtty_byte_oversample;


static void radio_write_reg_start(uint8_t reg);
static void radio_write_reg_continuing(uint8_t data);
static void radio_write_reg_end(void);
static void radio_rtty_write_bits(uint8_t max_fifo_write);
static void radio_fsk_set_fifo_threshold(uint8_t l);

inline uint16_t min(uint16_t in1, uint16_t in2)
{
	if (in1 > in2)
		return in2;
	else
		return in1;
}



void radio_write_fsk_config(radio_fsk_settings_t *s)
{
	uint8_t mode = radio_read_single_reg(REG_OP_MODE);
	mode |= (1<<3); //set LF range


	if (mode & (1<<7))  //if in lora mode
		radio_write_single_reg(REG_OP_MODE,(mode & ~(uint8_t)7));		//set to sleep mode so fsk bit can be written
	else
		radio_write_single_reg(REG_OP_MODE,(mode & ~(uint8_t)7) | 1);	//set to standby mode so various settings can be written

	//put into fsk mode
	mode = radio_read_single_reg(REG_OP_MODE);
	radio_write_single_reg(REG_OP_MODE,mode & ~(uint8_t)(7<<5));         //set to FSK

	//write modem config
	radio_write_single_reg(REG_BITRATE_LSB,s->bitrate&0xFF);
	radio_write_single_reg(REG_BITRATE_MSB,((s->bitrate)>>8)&0xFF);
	radio_write_single_reg(REG_FDEV_LSB,s->freq_dev&0xFF);
	radio_write_single_reg(REG_FDEV_MSB,((s->freq_dev)>>8)&0xFF);
	radio_write_single_reg(REG_PREAMBLE_LSB_FSK,s->preamble_size&0xFF);
	radio_write_single_reg(REG_PREAMBLE_MSB_FSK,((s->preamble_size)>>8)&0xFF);


	if (s->enable_sync)
		radio_write_single_reg(REG_SYNC_CONFIG, 3 | (1<<4) | (2<<6));
	else
		radio_write_single_reg(REG_SYNC_CONFIG, 3 | (2<<6));

	mode = radio_read_single_reg(REG_PACKET_CONFIG1);
	if (s->enable_crc)
		radio_write_single_reg(REG_PACKET_CONFIG1,mode | (1<<4));
	else
		radio_write_single_reg(REG_PACKET_CONFIG1,mode & ~(1<<4));



}

//will change mode to standby if not already in standby or sleep
//if not in lora, will change to lora mode
void radio_write_lora_config(radio_lora_settings_t *s)
{
	uint8_t mode = radio_read_single_reg(REG_OP_MODE);
	mode |= (1<<3); //set LF range

	//check in lora mode
	if ((mode & (1<<7)) == 0){
		radio_write_single_reg(REG_OP_MODE,mode & ~(uint8_t)7);		//set to sleep mode so lora bit can be written
		mode = radio_read_single_reg(REG_OP_MODE);
		radio_write_single_reg(REG_OP_MODE,mode | (1<<7));
	}
	else{
		//check in right mode to change lora registers
		if (!(((mode&MODE_MASK) == MODE_SLEEP) | ((mode&MODE_MASK) == MODE_STNDBY)))
		{
			radio_write_single_reg(REG_OP_MODE,(mode & ~(uint8_t)7) | 1);  //put into standby
		}
	}

	//put into lora mode
	//mode = radio_read_single_reg(REG_OP_MODE);
	//radio_write_single_reg(REG_OP_MODE,mode | (1<<7));

	//write modem config
	radio_write_single_reg(REG_MODEM_CONFIG1,
			(s->bandwidth&0xF0) | (s->coding_rate&0xE) | (s->implicit_mode&1));
	radio_write_single_reg(REG_MODEM_CONFIG2,
			((s->spreading_factor&0xF)<<4) | ((s->crc_en&0x1)<<2) | (s->implicit_mode&1));

	mode = radio_read_single_reg(REG_MODEM_CONFIG3);
	mode = mode & ~(1<<3);
	radio_write_single_reg(REG_MODEM_CONFIG3, mode | ((s->low_datarate&0x1)<<3) | (1<<2));  //also turn on auto lna

	if (s->spreading_factor == 6)
	{

		//-Set SpreadingFactor = 6 in RegModemConfig2
		//- The header must be set to Implicit mode.
		//- Set the bit field DetectionOptimize of register RegLoRaDetectOptimize to value "0b101".
		//- Write 0x0C in the register RegDetectionThreshold.
	}
	else
	{
		//unset the above
	}

	//LNA?

}

void radio_set_preamble(uint16_t pre)
{

}

void radio_sleep(void)
{
	uint8_t mode = radio_read_single_reg(REG_OP_MODE);
    radio_write_single_reg(REG_OP_MODE,mode & ~(uint8_t)7);

}

void radio_standby(void)
{
	uint8_t mode = radio_read_single_reg(REG_OP_MODE);
    radio_write_single_reg(REG_OP_MODE,(mode & ~(uint8_t)7) | 1);

}

void radio_high_power(void)
{
	radio_write_single_reg(REG_PA_CONFIG,POWER_HIGH);
}

void radio_pa_off(void)
{
	radio_write_single_reg(REG_PA_CONFIG,0x00);
}

void radio_lna_max(void)
{
	radio_write_single_reg(REG_LNA,0x23);

}

uint8_t radio_get_status(void)
{
	return radio_read_single_reg(REG_OP_MODE);
}

void radio_set_frequency_frreg(uint32_t f)
{
	radio_write_single_reg(REG_FRF_LSB,f & 0xFF);
	f >>= 8;
	radio_write_single_reg(REG_FRF_MID,f & 0xFF);
	f >>= 8;
	radio_write_single_reg(REG_FRF_MSB,f & 0xFF);
}

void radio_set_frequency_frq(uint32_t f)
{
	uint64_t reg;
	reg = (uint64_t)f << 19;
	reg = reg / 32000000L;

	radio_set_frequency_frreg((uint32_t)reg);


}


void radio_set_slow_packet_time(void)
{


}

void radio_set_explicit_rx_mode(uint8_t len, uint8_t rate, uint8_t crc_en)
{

}

void radio_set_implicit_mode(void)
{

}

//0 - done, 1 - still sending
uint8_t lora_in_progress(void)
{
	if (radio_read_single_reg(REG_IRQ_FLAGS) & (1<<3))
		return 0;
	else
		return 1;
}

//0 - below threshold, 1-above threshold
uint8_t radio_fsk_poll_fifo_level(void)
{
	if (radio_read_single_reg(REG_IRQ_FLAGS2) & (1<<5))
		return 1;
	else
		return 0;
}

static void radio_fsk_set_fifo_threshold(uint8_t l)
{
	uint8_t r = radio_read_single_reg(REG_FIFO_THRESH);
	radio_write_single_reg(REG_FIFO_THRESH,(r&(~0x3F)) | l);
}

void radio_start_tx_rtty(char *data, rtty_baud_t baud, uint8_t deviation)
{
	rtty_current_byte = data;
	rtty_bit_counter_mask = 0;

	radio_fsk_settings_t s1;
	s1.freq_dev = deviation;
	s1.enable_sync = 0;
	s1.preamble_size = 0;
	s1.enable_crc = 0;

	if (baud == BAUD_50)
	{
		s1.bitrate = 40000;
		rtty_byte_oversample = 2;
	}
	else if (baud == BAUD_300)
	{

	}
	else  //baud_600
	{

	}

	uint8_t mode = radio_read_single_reg(REG_OP_MODE);
	if (((mode & 7) != MODE_TX) || (mode & (1<<7))!= 0)
	{
		radio_write_fsk_config(&s1);
		radio_fsk_set_fifo_threshold(RTTY_FIFO_THRESHOLD);
		uint8_t r = radio_read_single_reg(REG_OP_MODE) & 0xF8;
		radio_write_single_reg(REG_OP_MODE, r | MODE_TX);
	}

	radio_rtty_write_bits(64);

}

uint8_t radio_rtty_poll_buffer_refill()
{
	uint8_t out = 0;
	while (radio_fsk_poll_fifo_level() == 0 && *rtty_current_byte){
		radio_rtty_write_bits(64-RTTY_FIFO_THRESHOLD);
		out = 1;
	}
	return out;
}

//returns 0 when done
uint8_t rtty_in_progress(void)
{
	if (*rtty_current_byte)
		return 1;
	else
	{
		uint8_t s = radio_read_single_reg(REG_IRQ_FLAGS2);
		if (s & (1<<6) || s & (1<<3))
			return 0;
		else
			return 1;
	}

}

static void radio_rtty_write_bits(uint8_t max_fifo_write)
{
	uint8_t written = 0;
	uint8_t data,c;

	radio_write_reg_start(0);

	while((written < (max_fifo_write-rtty_byte_oversample+1))
			&& (*rtty_current_byte != 0))
	{
		if (rtty_bit_counter_mask == 0)  //start bit
		{
			data = 0x0;
			rtty_bit_counter_mask = (1<<0);
		}
		else if (rtty_bit_counter_mask >= (1<<7))  //stop bits
		{
			rtty_bit_counter_mask <<= 1;
			data = 0xFF;
			if (rtty_bit_counter_mask >= (1<<9))
			{
				rtty_bit_counter_mask = 0;
				rtty_current_byte++;
			}
		}
		else  //databits
		{
			if (*rtty_current_byte & rtty_bit_counter_mask)
				data = 0xFF;
			else
				data = 0x0;
			rtty_bit_counter_mask <<= 1;
		}

		for (c = 0; c < rtty_byte_oversample; c++)
			radio_write_reg_continuing(data);
		written += rtty_byte_oversample;
	}

	radio_write_reg_end();
}

void radio_tx_packet(uint8_t *data, uint16_t len)
{

	radio_write_single_reg(REG_IRQ_FLAGS,1<<3);  //clear TxDone

	uint8_t r = radio_read_single_reg(REG_FIFO_TX_BASE_ADDR);
	radio_write_single_reg(REG_FIFO_ADDR_PTR,r);

	//radio_write_single_reg(REG_FIFO_TX_BASE_ADDR,0);
	//radio_write_single_reg(REG_FIFO_ADDR_PTR,0);

	radio_write_burst_reg(0,data,len);
	radio_write_single_reg(REG_PAYLOAD_LENGTH_LORA,len);

	//write mode tx
	r = radio_read_single_reg(REG_OP_MODE) & 0xF8;
	radio_write_single_reg(REG_OP_MODE, r | MODE_TX);

}

void radio_carrier_on(void)
{

}


void radio_init()
{
	rcc_periph_clock_enable(R_RCC_SPI);
	rcc_periph_clock_enable(R_RCC_GPIO);
	gpio_mode_setup(R_SPI_PORT, GPIO_MODE_AF, GPIO_PUPD_NONE,
			R_SPI_PINS);
	gpio_set_af(R_SPI_PORT, R_SPI_AFn, R_SPI_PINS);
	gpio_mode_setup(R_CS_PORT, GPIO_MODE_OUTPUT, GPIO_PUPD_NONE,
			R_CS_PIN);

	// Reset and enable the SPI periph
	spi_reset(R_SPI);
	spi_init_master(R_SPI, SPI_CR1_BAUDRATE_FPCLK_DIV_64,
			SPI_CR1_CPOL_CLK_TO_0_WHEN_IDLE,
			SPI_CR1_CPHA_CLK_TRANSITION_1,
			SPI_CR1_CRCL_8BIT,
			SPI_CR1_MSBFIRST);

	// Trigger an RXNE event when we have 8 bits (one byte) in the buffer
	spi_fifo_reception_threshold_8bit(R_SPI);

	// NSS must be set high for the peripheral to function
	spi_enable_software_slave_management(R_SPI);
	spi_set_nss_high(R_SPI);
	gpio_set(R_CS_PORT, R_CS_PIN);

	// Enable
	spi_enable(R_SPI);

	radio_sleep();


}

uint8_t radio_read_version(void)
{
	return radio_read_single_reg(REG_VERSION);
}

void radio_set_continuous_rx(void)
{


	//go into rx mode
	uint8_t r = radio_read_single_reg(REG_OP_MODE) & 0xF8;
	radio_write_single_reg(REG_OP_MODE, r | MODE_RX);

}

void radio_set_single_rx(void)
{
	//go into rx mode
	uint8_t r = radio_read_single_reg(REG_OP_MODE) & 0xF8;
	radio_write_single_reg(REG_OP_MODE, r | MODE_RX_SINGLE);

}
/*
uint8_t radio_new_data(void)
{
	//check for RxDone
	if (radio_read_single_reg(REG_IRQ_FLAGS) & IRQ_RX_DONE)
		return 1;
	else
		return 0;
	//also payloadcrcerror
}

void radio_clear_irq(void)
{
	radio_write_single_reg(REG_IRQ_FLAGS, 0xFF);
}
*/

int16_t radio_check_read_rx_packet(uint16_t max_len, uint8_t *buff, uint8_t check_crc)
{
	//check rx timeout, validheader
	uint8_t f = radio_read_single_reg(REG_IRQ_FLAGS);
	//clear flags
	radio_write_single_reg(REG_IRQ_FLAGS, 0xFF);

	if ((f & IRQ_RX_DONE) == 0)
		return 0;

	if ((f & IRQ_CRC_ERROR) && check_crc)
		return -2;


	//RxNbBytes - number of bytes received
	uint16_t c = radio_read_single_reg(REG_RX_NB_BYTES);

	//FifoAddrPtr - where the modem has written up to
	//set FifoAddrPtr to FifoRxCurrentAddr
	f = radio_read_single_reg(REG_FIFO_RX_CURRENT_ADDR);
	radio_write_single_reg(REG_FIFO_ADDR_PTR,f);

	//read Fifo RxNbTimes
	radio_read_burst_reg(REG_FIFO, buff, min(max_len,c));

	return min(max_len,c);
}

uint8_t radio_read_single_reg(uint8_t reg)
{
	while(SPI_SR(R_SPI) & SPI_SR_BSY);
	gpio_clear(R_CS_PORT, R_CS_PIN);
	spi_send8(R_SPI, reg & 0x7F);
	spi_read8(R_SPI);
	// Wait until send FIFO is empty
	while(SPI_SR(R_SPI) & SPI_SR_BSY);
	spi_send8(R_SPI, 0x0);
	while(SPI_SR(R_SPI) & SPI_SR_BSY);
	uint8_t out = spi_read8(R_SPI);
	gpio_set(R_CS_PORT, R_CS_PIN);
	return out;
}

void radio_read_burst_reg(uint8_t reg, uint8_t *buff, uint16_t len)
{
	while(SPI_SR(R_SPI) & SPI_SR_BSY);
	gpio_clear(R_CS_PORT, R_CS_PIN);
	spi_send8(R_SPI, reg & 0x7F);
	spi_read8(R_SPI);
	// Wait until send FIFO is empty
	while(SPI_SR(R_SPI) & SPI_SR_BSY);
	uint16_t i;
	for ( i = 0; i < len; i++)
	{
		spi_send8(R_SPI, 0x0);
		while(SPI_SR(R_SPI) & SPI_SR_BSY);
		buff[i] = spi_read8(R_SPI);
	}
	gpio_set(R_CS_PORT, R_CS_PIN);
}

void radio_write_single_reg(uint8_t reg, uint8_t data)
{
	while(SPI_SR(R_SPI) & SPI_SR_BSY);
	gpio_clear(R_CS_PORT, R_CS_PIN);
	spi_send8(R_SPI, reg | (1<<7));
	spi_read8(R_SPI);
	// Wait until send FIFO is empty
	while(SPI_SR(R_SPI) & SPI_SR_BSY);
	spi_send8(R_SPI, data);
	spi_read8(R_SPI);
	// Wait until send FIFO is empty
	while(SPI_SR(R_SPI) & SPI_SR_BSY);
	gpio_set(R_CS_PORT, R_CS_PIN);
}

void radio_write_burst_reg(uint8_t reg, uint8_t *data, uint16_t len)
{
	while(SPI_SR(R_SPI) & SPI_SR_BSY);
	gpio_clear(R_CS_PORT, R_CS_PIN);
	spi_send8(R_SPI, reg | (1<<7));
	spi_read8(R_SPI);
	// Wait until send FIFO is empty
	uint16_t i = 0;
	for (i = 0; i < len; i++)
	{
		while(SPI_SR(R_SPI) & SPI_SR_BSY);
		spi_send8(R_SPI, data[i]);
		spi_read8(R_SPI);
	}
	// Wait until send FIFO is empty
	while(SPI_SR(R_SPI) & SPI_SR_BSY);
	gpio_set(R_CS_PORT, R_CS_PIN);
}

static void radio_write_reg_start(uint8_t reg)
{
	while(SPI_SR(R_SPI) & SPI_SR_BSY);
	gpio_clear(R_CS_PORT, R_CS_PIN);
	spi_send8(R_SPI, reg | (1<<7));
	spi_read8(R_SPI);
}

static void radio_write_reg_continuing(uint8_t data)
{
	while(SPI_SR(R_SPI) & SPI_SR_BSY);
	spi_send8(R_SPI, data);
	spi_read8(R_SPI);
}

static void radio_write_reg_end(void)
{
	while(SPI_SR(R_SPI) & SPI_SR_BSY);
	gpio_set(R_CS_PORT, R_CS_PIN);
}
