suspaceflight/lora-tracker/(commit log)

2014-09-15 initial board commit
    [lora.brd, lora.sch]
2014-09-15 some nudging
    [lora.brd, lora.sch]
2014-09-16 added esd diodes and supply reading
    [lora.brd, lora.sch]
2014-09-16 intial commit of basesttaion
    [basestation.brd, basestation.sch]
2014-09-17 added boot0 to tracker, some wiring on basestation
    [basestation.brd, basestation.sch, lora.brd, lora.sch]
2014-09-17 initial route
    [basestation.brd, basestation.sch, lora.brd, lora.sch]
2014-09-17 adding interrupt line to raido
    [basestation.brd, basestation.sch, lora.brd, lora.sch]
2014-09-17 minor changes
    [basestation.brd, basestation.sch]
2014-09-18 some stuff changed lol
    [basestation.brd, basestation.sch, lora.brd, lora.sch]
2014-09-19 poking some routing
    [basestation.brd]
2014-09-21 proded silk
    [basestation.brd, basestation.sch]
2014-09-23 fixing top silk
    [basestation.brd]
2014-09-24 adding stuff to silk
    [basestation.brd, basestation.sch, lora.brd, lora.sch]
2014-09-24 deleting part nmae
    [basestation.brd]
2014-09-27 Add Slim LORA Board.
    [lora-slim.brd, lora-slim.sch]
2014-09-27 couple drc fixes
    [lora-slim.brd]
2014-09-27 added esd protection
    [basestation.brd, basestation.sch]
2014-09-27 started through hole lora
    [th-lora.brd, th-lora.sch]
2014-09-28 finishing off
    [th-lora.brd, th-lora.sch]
2014-09-28 connecting clkout
    [lora-slim.brd, lora-slim.sch]
2014-09-29 sent off
    [combined.GBL, combined.GBO, combined.GBP, combined.GBS, combined.GTL, combined.GTO, combined.GTP, combined.GTS]
2014-10-04 adding part values
    [basestation.brd, basestation.sch]
2014-10-27 adding copyright notice
    [basestation.brd, basestation.sch, lora-slim.brd, lora.brd, th-lora.brd]
2014-12-01 now with iwdg and battery voltage
2014-12-18 adding cad stuff
    [switchcap.SLDPRT]
2015-02-17 fixing rtty freezing issue
    [radio.c]
2015-03-07 freed up space, changed led status, flight mode every sentence
2016-02-08 started through-hole tracker code
2016-04-01 some bug fixes, now handles altitude diffs
    [main.c]
2016-04-30 adding radiation sensor stuff
2016-05-07 some bug fixes, going to start rotary encoder stuff
    [main.c, telem_parser.c]
2016-05-07 rotary encoder now better
